Believe-love/Arduino-Tracking-Car-With-PID-control/README.md

详情请跳转：https://blog.csdn.net/zhoumy66/article/details/158206681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
